BryceBeagle/silicon-valley/hardware/led-test-board/led-test-board.kicad_sch

## KiCad design hardware/led-test-board/led-test-board.kicad_sch (2022-07-29)

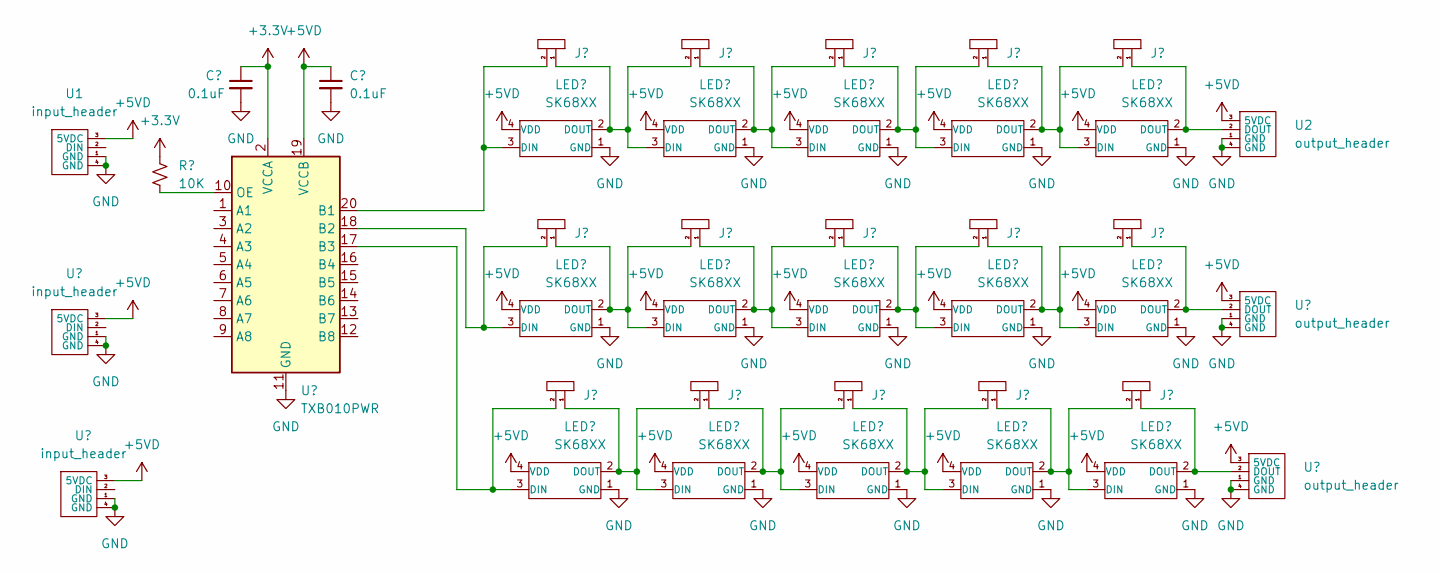
[picture p1: schematic led-test-board.kicad_sch]

Parts:
U1: input_header
U2: output_header

Connections:
unnamed: U1.1 (GND), U1.4 (GND)
unnamed: U2.1 (GND), U2.4 (GND)
