BryceBeagle/silicon-valley/(commit log)

2022-07-29 Initial schematic for LED test board
    This board has a couple varieties (package size) of LED arrangements and
    test points
    [silicon_valley.kicad_pcb, silicon_valley.kicad_sch]
2022-08-02 Fix kicad project naming
    Change kicad project naming to be specific to specific to the test board
    rather than the project as a whole
    [led-test-board.kicad_pcb, led-test-board.kicad_sch]
